DiabolicAnt/cochera_IoT/docs/practica2/evidencias/cliente_websocket.png

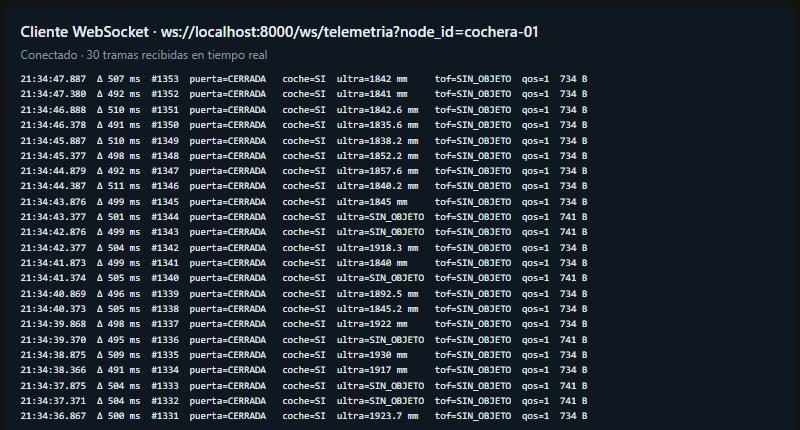
docs/practica2/evidencias/cliente_websocket.png
