DiabolicAnt/cochera_IoT/docs/semana1/evidencias/fotos/nodo_y_carro.jpg

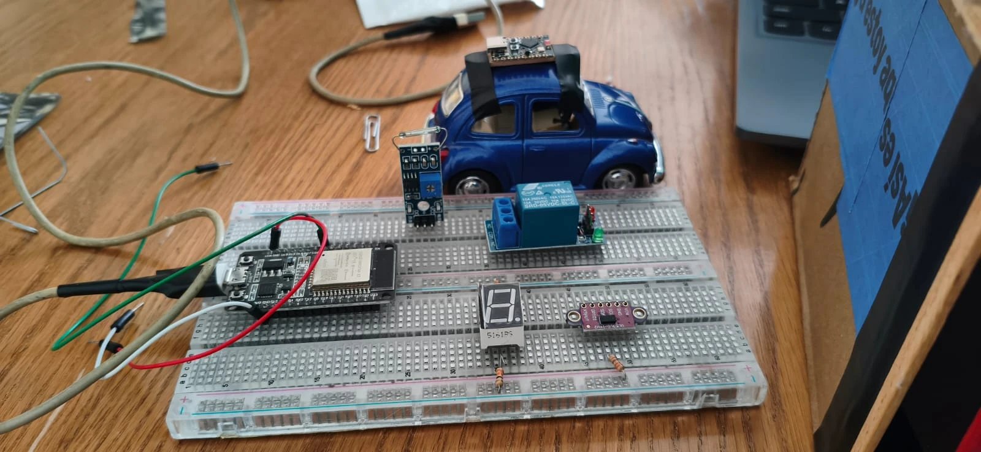
docs/semana1/evidencias/fotos/nodo_y_carro.jpg
