DiabolicAnt/cochera_IoT/docs/practica2/evidencias/app_1_cerrada.jpg

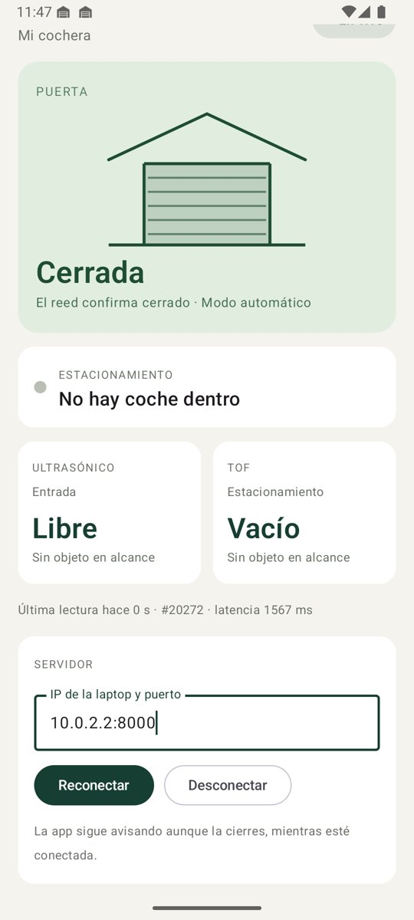
docs/practica2/evidencias/app_1_cerrada.jpg
