DiabolicAnt/cochera_IoT/docs/practica2/evidencias/app_2_abriendo_notificacion.jpg

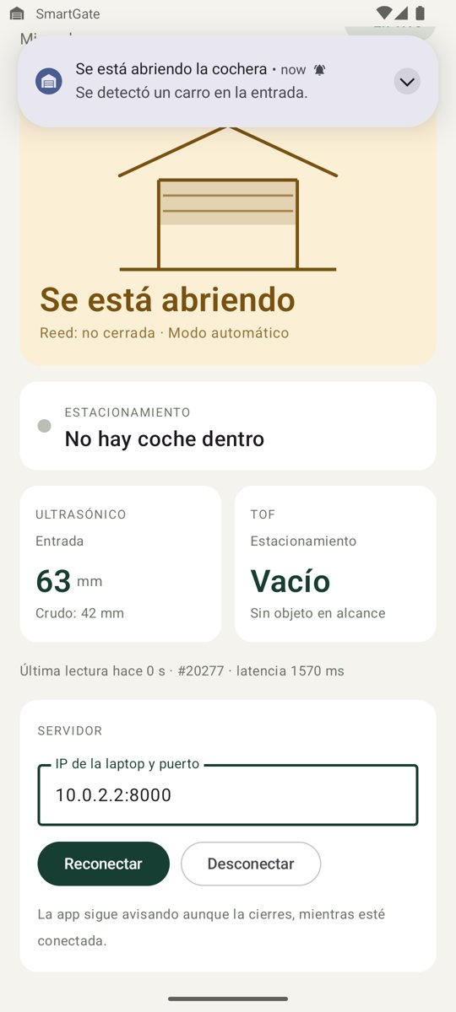
docs/practica2/evidencias/app_2_abriendo_notificacion.jpg
