DiabolicAnt/cochera_IoT/docs/practica2/evidencias/app_4_cerrando.jpg

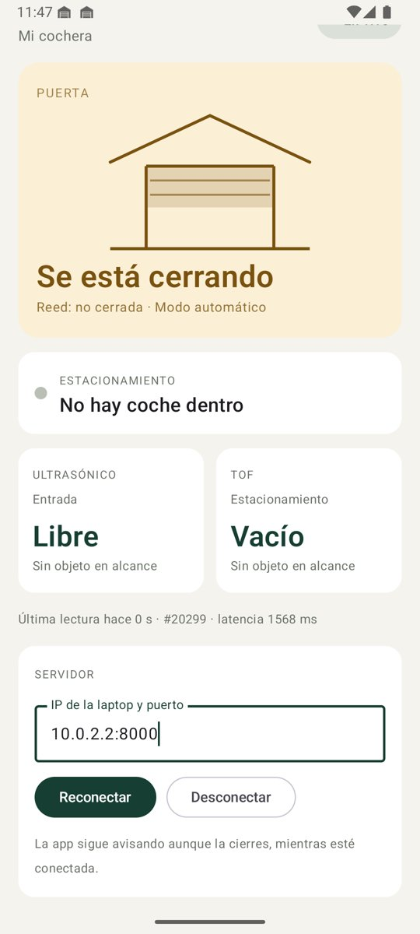
docs/practica2/evidencias/app_4_cerrando.jpg
