DiabolicAnt/cochera_IoT/docs/practica2/evidencias/app_5_cerrada_notificacion.jpg

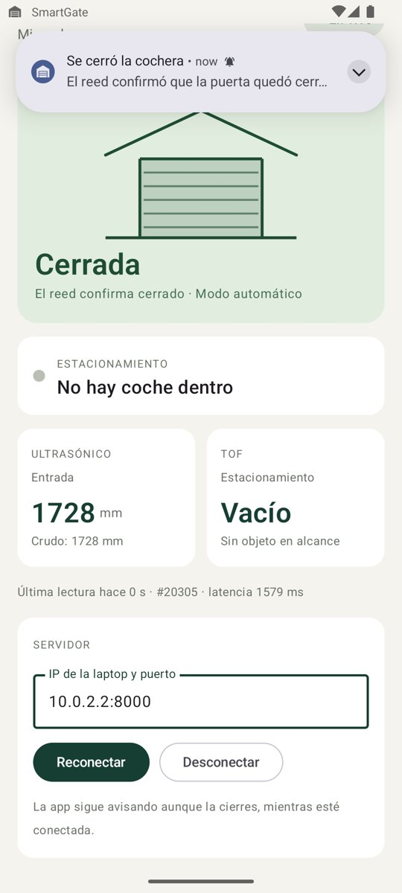
docs/practica2/evidencias/app_5_cerrada_notificacion.jpg
