DiabolicAnt/cochera_IoT/docs/practica2/evidencias/app_6_coche_dentro.jpg

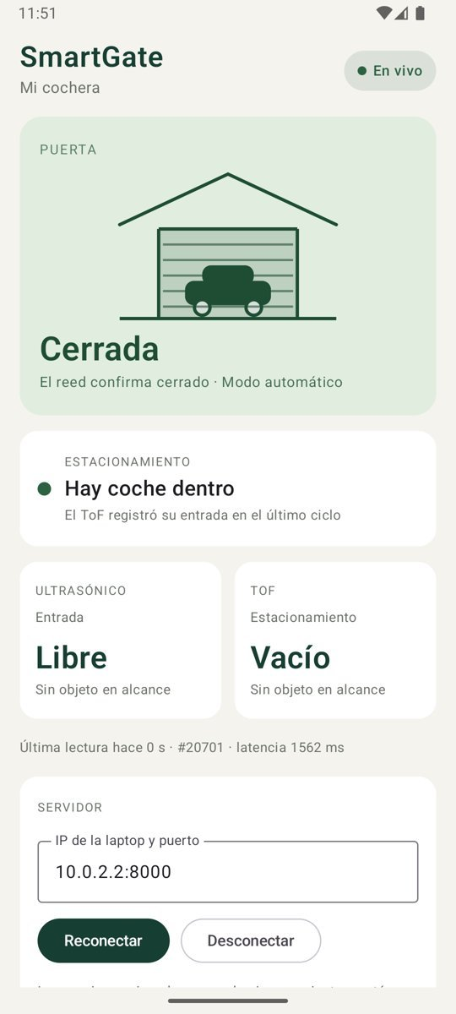
docs/practica2/evidencias/app_6_coche_dentro.jpg
