DiabolicAnt/cochera_IoT/docs/practica2/evidencias/celular_1_cerrada.jpg

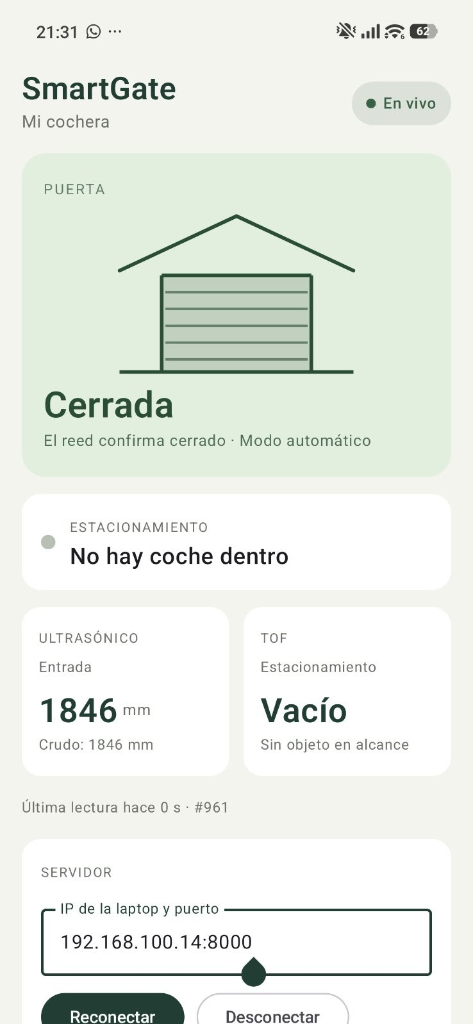
docs/practica2/evidencias/celular_1_cerrada.jpg
