DiabolicAnt/cochera_IoT/docs/practica2/evidencias/celular_2_abriendo.jpg

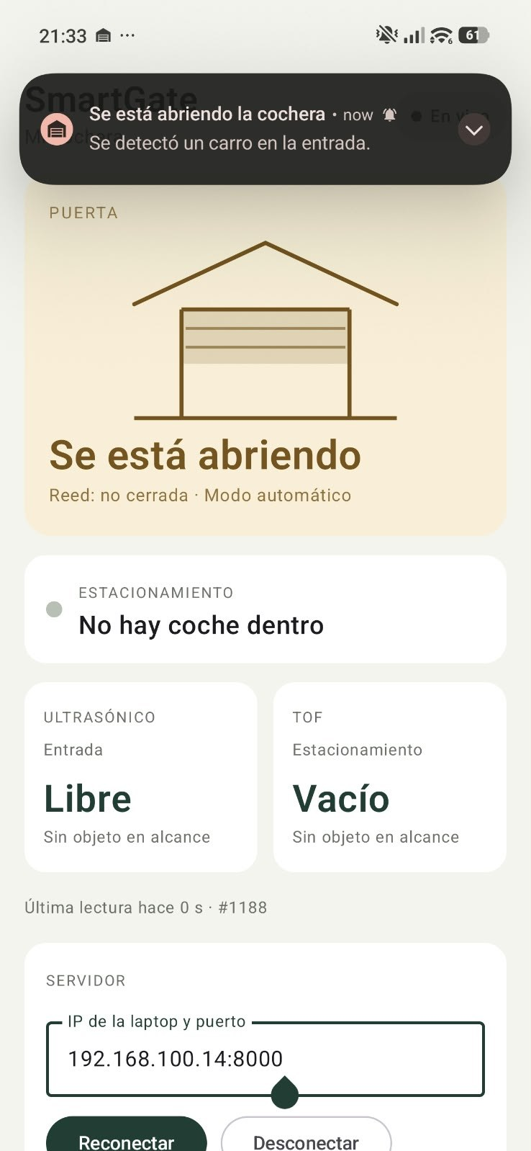
docs/practica2/evidencias/celular_2_abriendo.jpg
