DiabolicAnt/cochera_IoT/docs/practica2/evidencias/celular_3_abierta.jpg

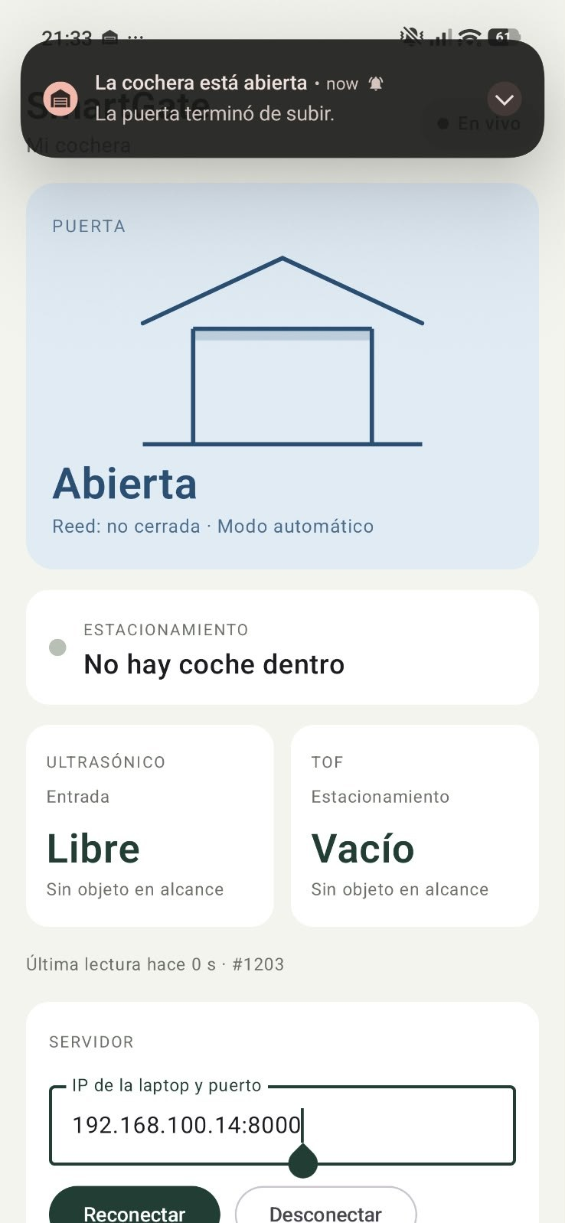
docs/practica2/evidencias/celular_3_abierta.jpg
