DiabolicAnt/cochera_IoT/docs/practica2/evidencias/celular_4_coche_dentro.jpg

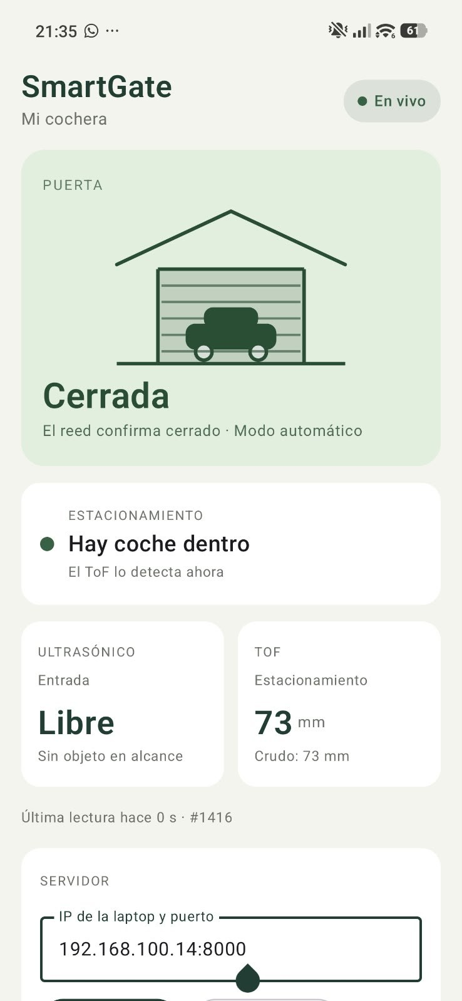
docs/practica2/evidencias/celular_4_coche_dentro.jpg
