DiabolicAnt/cochera_IoT/docs/practica3/evidencias/dashboard_completo.png

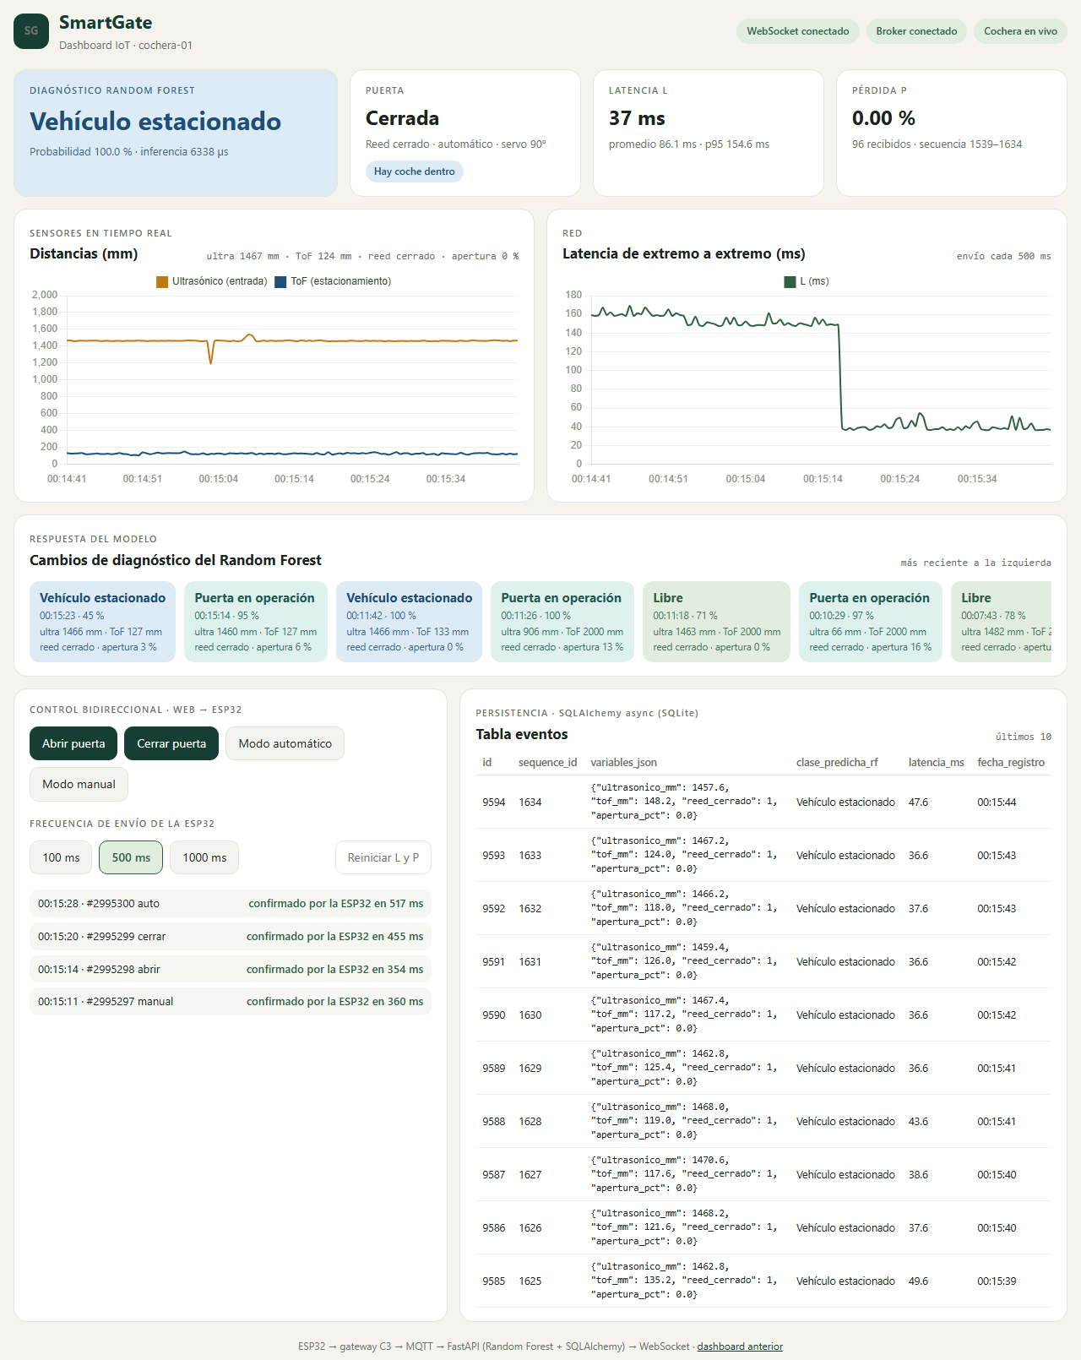
docs/practica3/evidencias/dashboard_completo.png
