DiabolicAnt/cochera_IoT/(commit log)

2026-10-24 Firmware del nodo sensor: ultrasonico, ToF, reed y servo
    Control local de la puerta sin radio (la ESP32 hace brownout con BLE/WiFi). Incluye filtro de promedio movil de 5 lecturas y salida JSON por UART2.
    [SmartGate_CicloEntrada.h, SmartGate_ESP32_Cochera.ino, SmartGate_Edge.h]
2026-10-24 Programas de prueba: escaneo I2C, ultrasonico crudo y servo aislado
2026-10-24 Evidencias de la semana 1: fotos del montaje y capturas del monitor serie
2026-10-24 Reporte de avance de la semana 1 (Word y PDF)
2026-10-26 Gateway ESP32-C3: puente UART a WiFi/MQTT con QoS configurable
    Recibe el JSON de la ESP32 por UART, agrega hora NTP y datos de red y
    publica con esp-mqtt (QoS 0/1, Last Will). Mide la duracion de publish()
    y del loop para el experimento de QoS. TX a 8.5 dBm porque la SuperMini
    no se asocia al router a potencia maxima.
2026-10-26 Backend FastAPI: MQTT, validacion, SQLite, estadisticas y WebSocket
    Suscripcion paho-mqtt con paso seguro al Event Loop, validacion Pydantic,
    SQLite, endpoint de estadisticas (perdida, jitter, publish) y el stream
    ws/telemetria de la guia, filtrable por node_id. Incluye dashboard web,
    simulador, configuracion de Mosquitto y 14 pruebas.
2026-10-26 App Android SmartGate: estado de la cochera, sensores y notificaciones
    Kotlin + Jetpack Compose. Un servicio en primer plano mantiene el
    WebSocket (OkHttp) y notifica cuando la cochera se esta abriendo, queda
    abierta y se cierra. Muestra si hay coche dentro y el ultrasonico y el ToF.
2026-10-26 Reporte de la practica 2 y evidencias del experimento de QoS
    Reporte en Word y PDF, consolas de la ESP32, del gateway y de FastAPI,
    capturas de la app y del cliente WebSocket, y las corridas QoS 0/1 con
    red normal y degradada. README con la arquitectura de la practica 2.
2026-10-26 Reporte practica 2: capturas de la app en el celular
    Ciclo real visto en el telefono (21:31-21:35): cerrada, notificaciones de
    apertura y de puerta abierta, cerrada con el coche dentro (ToF a 73 mm) y
    la notificacion de cierre recibida con la app en segundo plano.
2026-10-26 Práctica 3: Random Forest, control bidireccional, ORM y dashboard Chart.js
    - Payload con node_id, sequence_id, timestamp_ms y data{ultrasonico, tof, reed, apertura}
    - Clasificador Random Forest (6 clases) reentrenado con la sesión real de la maqueta
    - Persistencia asíncrona SQLAlchemy (tabla eventos) y métricas L y P
    - Control Web -> WebSocket -> FastAPI -> MQTT -> gateway C3 -> UART (GPIO21 -> GPIO16) -> ESP32
    - Dashboard con Chart.js, insignia RF, botones de control y de frecuencia
    - Experimento 100/500/1000 ms, evidencias y reporte de la práctica 3
